RDaXx/PING37-Coupe-de-France-de-Robotique/BASE ROULANTE/MECA/Assemblage/Assemblage_moteur_roue.SLDASM

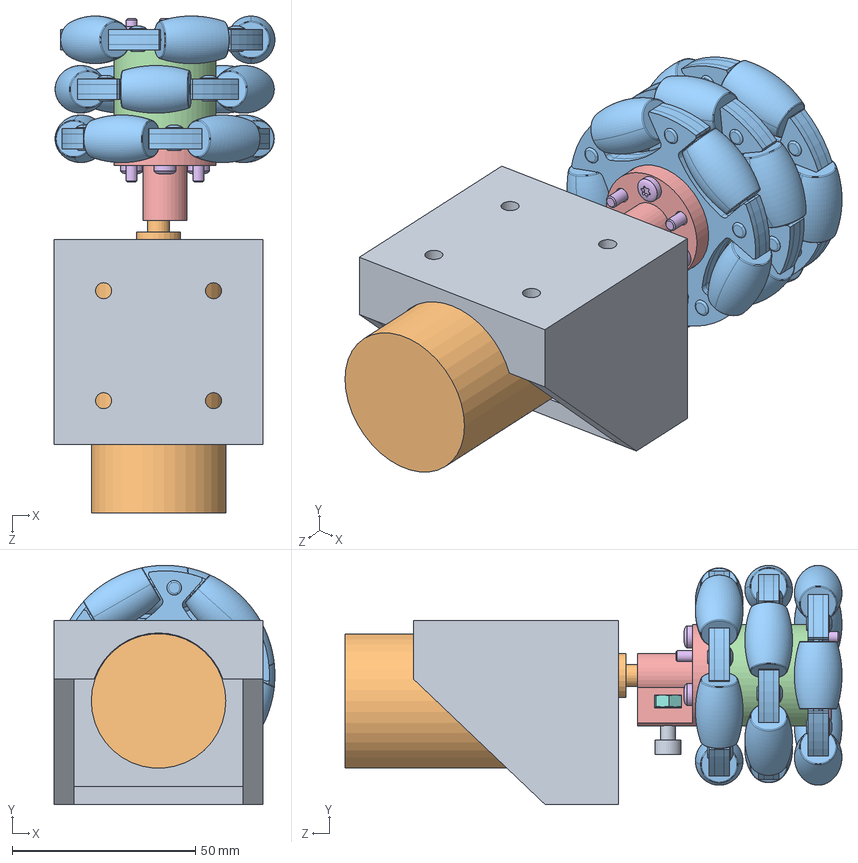
[picture p22: CAD file, 2023-02-07]
BASE ROULANTE/MECA/Assemblage/Assemblage_moteur_roue.SLDASM
60.2 x 65.3 x 135.6 mm
support_Moteur
2V DC Motor 251RPM
Omni Wheel_roller x 3
Omni Wheel_middle x 2
fixation_moteur
torx_socket_pan_head_M3x40.step x 6
Boulon_M3 x 6
Boulon_M4
M4_16
