RDaXx/PING37-Coupe-de-France-de-Robotique/BASE ROULANTE/MECA/Roue/Assemblage_roue.SLDASM

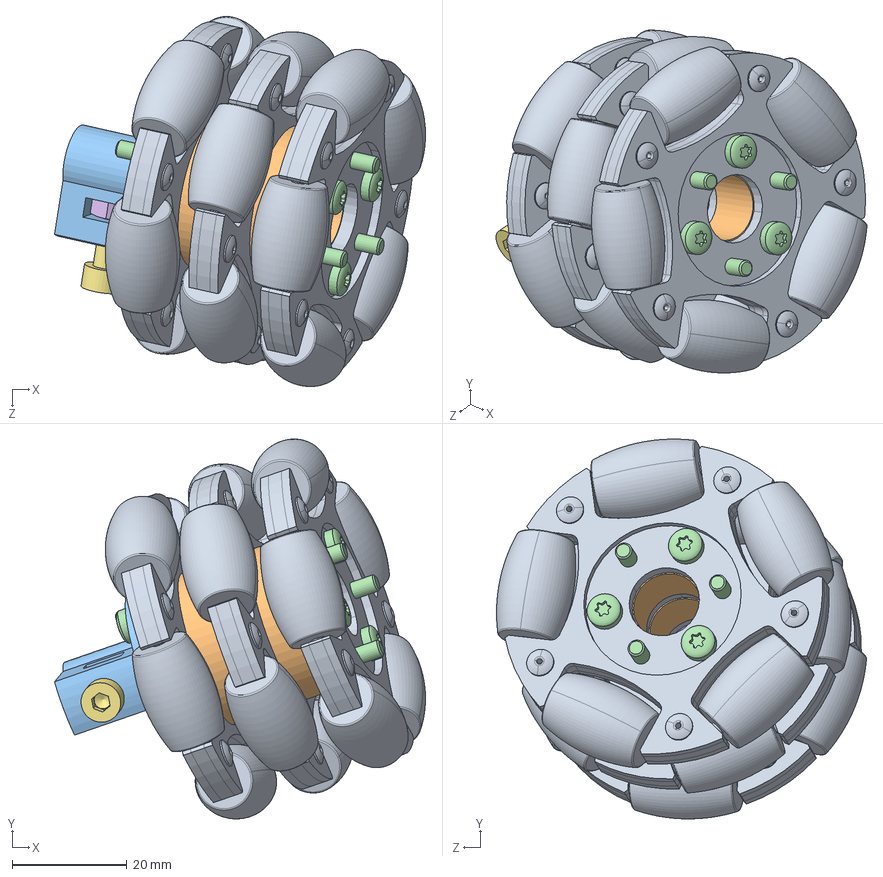
[picture p23: CAD file, 2023-02-07]
BASE ROULANTE/MECA/Roue/Assemblage_roue.SLDASM
64.6 x 66.1 x 64.4 mm
Omni Wheel_roller x 3
Omni Wheel_middle x 2
fixation_moteur
torx_socket_pan_head_M3x40.step x 6
Boulon_M3 x 6
Boulon_M4
M4_16
