RDaXx/PING37-Coupe-de-France-de-Robotique/BASE ROULANTE/MECA/Etage/etage_1.SLDPRT

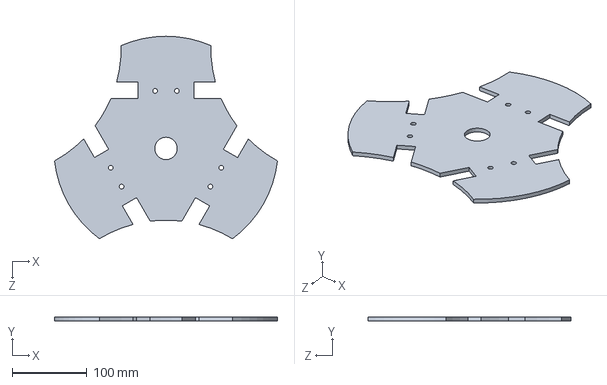
[picture p24: CAD file, 2023-02-07]
BASE ROULANTE/MECA/Etage/etage_1.SLDPRT
298.1 x 5.00 x 270.8 mm
