RDaXx/PING37-Coupe-de-France-de-Robotique/BASE ROULANTE/MECA/Moteurs/CarteMoteurs.SLDPRT

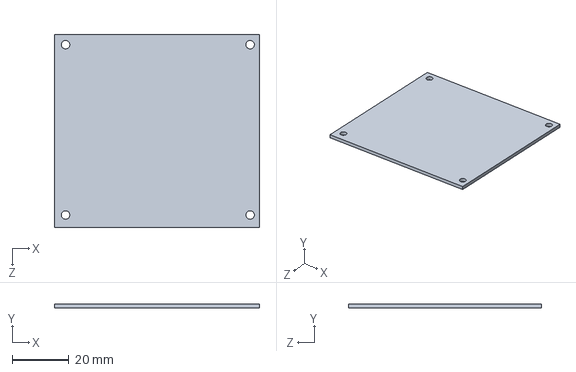
[picture p25: CAD file, 2023-02-07]
BASE ROULANTE/MECA/Moteurs/CarteMoteurs.SLDPRT
72.2 x 1.50 x 67.8 mm
