RDaXx/PING37-Coupe-de-France-de-Robotique/BASE ROULANTE/MECA/Profilé/User Library-4-AS-6-2020-VSLOT/profilé_2mm.sldprt

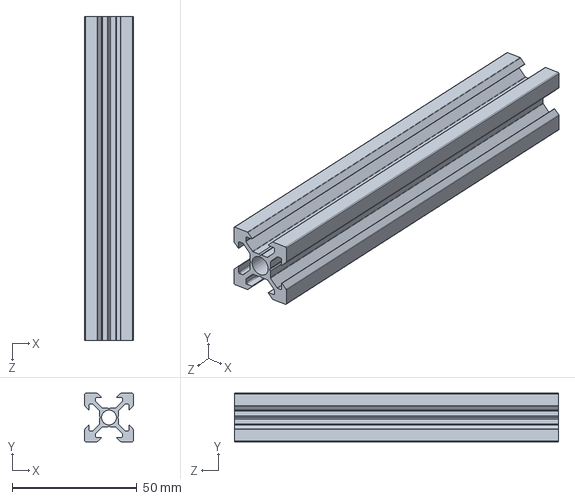
[picture p26: CAD file, 2023-02-07]
BASE ROULANTE/MECA/Profilé/User Library-4-AS-6-2020-VSLOT/profilé_2mm.sldprt
19.5 x 19.5 x 130.0 mm
