RDaXx/PING37-Coupe-de-France-de-Robotique/BASE ROULANTE/MECA/Roue/Omni Wheel_roller.SLDPRT

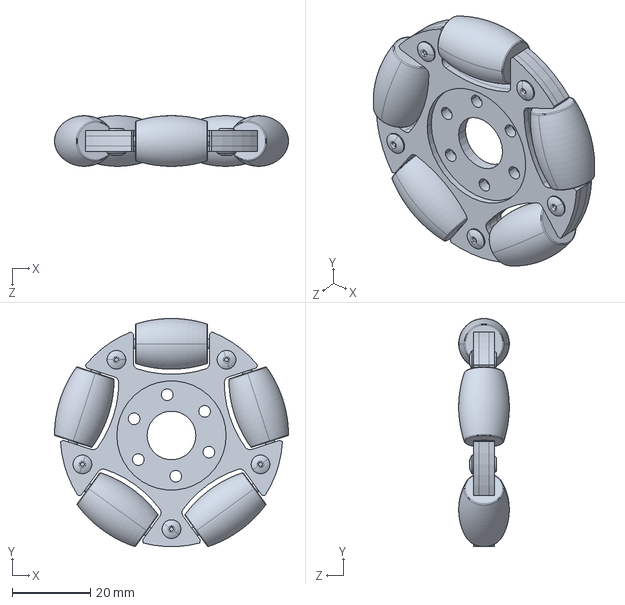
[picture p27: CAD file, 2023-02-07]
BASE ROULANTE/MECA/Roue/Omni Wheel_roller.SLDPRT
60.0 x 58.5 x 13.0 mm
