RDaXx/PING37-Coupe-de-France-de-Robotique/BASE ROULANTE/MECA/Visserie/Boulons/Boulon_M3.SLDPRT

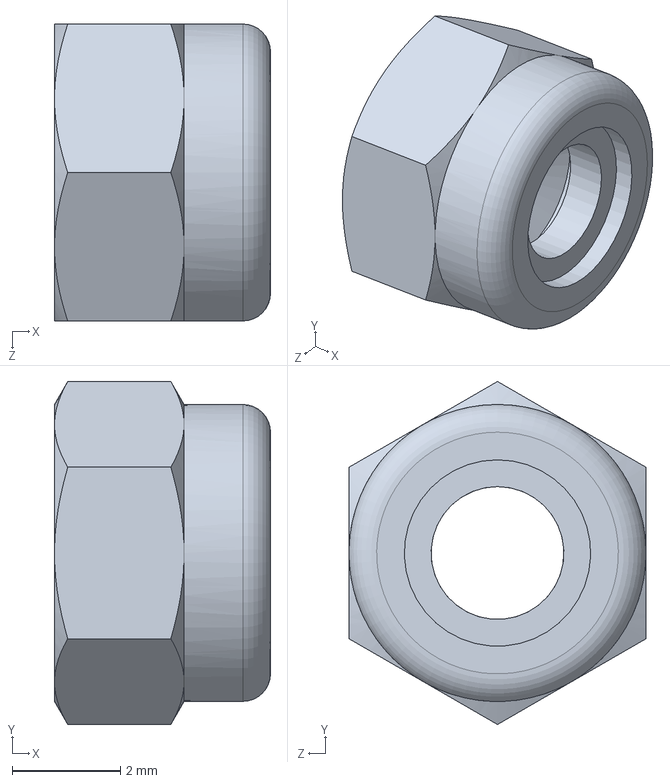
[picture p28: CAD file, 2023-02-07]
BASE ROULANTE/MECA/Visserie/Boulons/Boulon_M3.SLDPRT
4.00 x 6.35 x 5.50 mm
