RDaXx/PING37-Coupe-de-France-de-Robotique/BASE ROULANTE/MECA/Visserie/Vis/M3/torx_socket_pan_head_M3x35.step

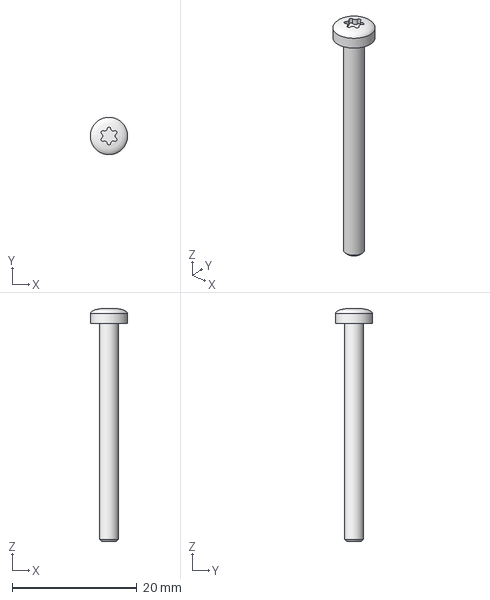
[picture p29: CAD file, 2023-02-07]
BASE ROULANTE/MECA/Visserie/Vis/M3/torx_socket_pan_head_M3x35.step
5.99 x 6.00 x 37.4 mm
