RDaXx/PING37-Coupe-de-France-de-Robotique/BASE ROULANTE/MECA/Visserie/Vis/M6/Vis_M6_20.SLDPRT

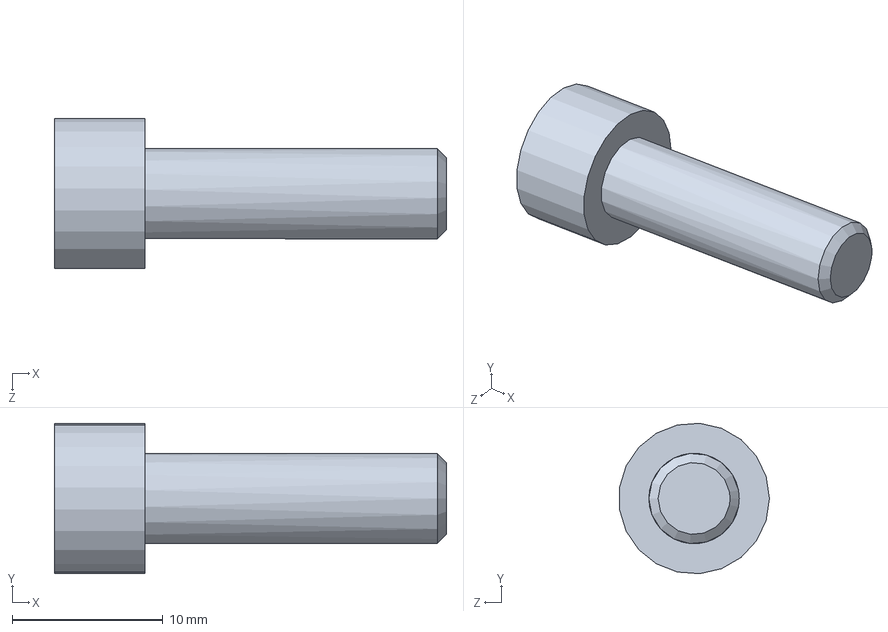
[picture p30: CAD file, 2023-02-07]
BASE ROULANTE/MECA/Visserie/Vis/M6/Vis_M6_20.SLDPRT
26.0 x 9.97 x 9.94 mm
