RDaXx/PING37-Coupe-de-France-de-Robotique/BASE ROULANTE/MECA/Etage/etage_2.SLDPRT

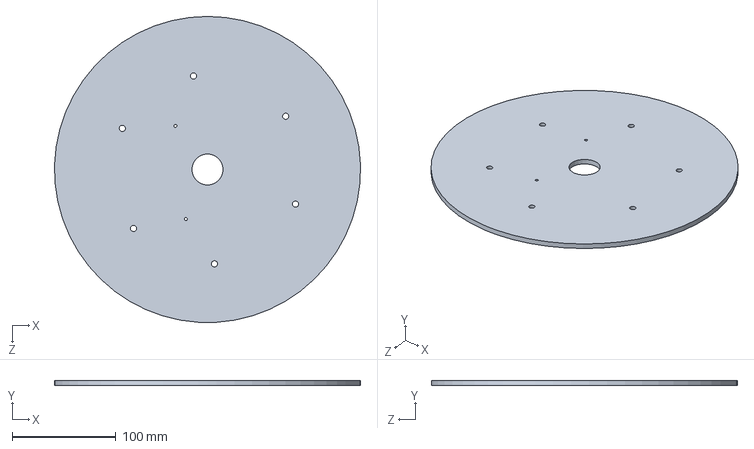
[picture p31: CAD file, 2023-02-07]
BASE ROULANTE/MECA/Etage/etage_2.SLDPRT
294.9 x 5.00 x 295.0 mm
