RDaXx/PING37-Coupe-de-France-de-Robotique/BASE ROULANTE/MECA/Moteurs/Support_CarteMoteursV2.SLDPRT

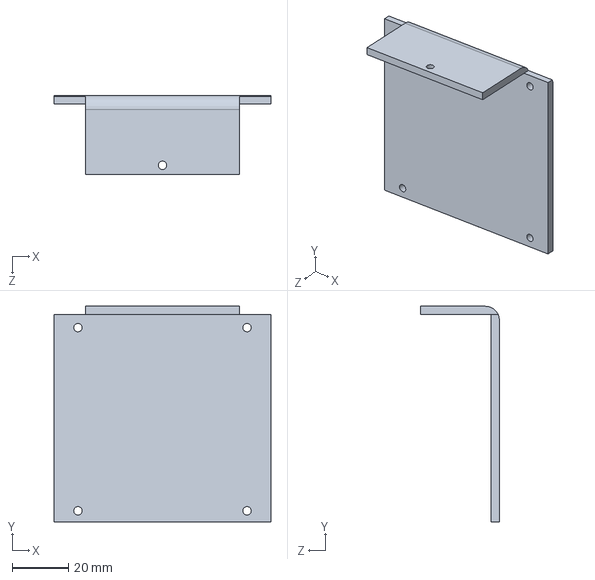
[picture p32: CAD file, 2023-02-07]
BASE ROULANTE/MECA/Moteurs/Support_CarteMoteursV2.SLDPRT
77.0 x 76.5 x 28.0 mm
