RDaXx/PING37-Coupe-de-France-de-Robotique/BASE ROULANTE/MECA/Roue/fixation_moteur.SLDPRT

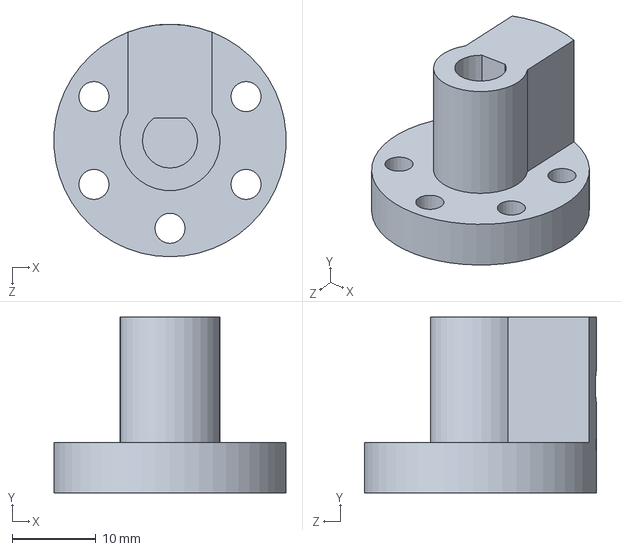
[picture p33: CAD file, 2023-02-07]
BASE ROULANTE/MECA/Roue/fixation_moteur.SLDPRT
27.7 x 21.0 x 27.8 mm
