RDaXx/PING37-Coupe-de-France-de-Robotique/BASE ROULANTE/MECA/Visserie/Boulons/Boulon_M4.SLDPRT

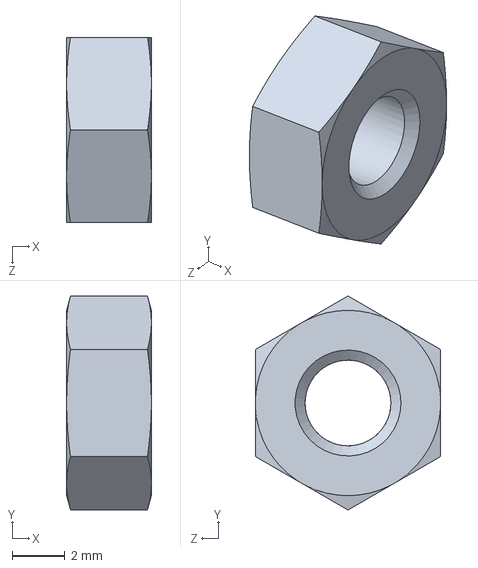
[picture p34: CAD file, 2023-02-07]
BASE ROULANTE/MECA/Visserie/Boulons/Boulon_M4.SLDPRT
3.20 x 8.08 x 7.00 mm
