RDaXx/PING37-Coupe-de-France-de-Robotique/BASE ROULANTE/MECA/Visserie/Vis/M3/torx_socket_pan_head_M3x25.step

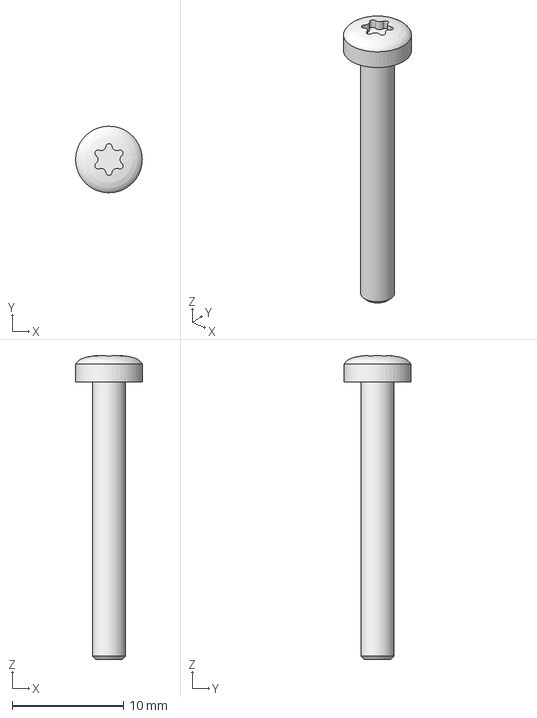
[picture p35: CAD file, 2023-02-07]
BASE ROULANTE/MECA/Visserie/Vis/M3/torx_socket_pan_head_M3x25.step
5.99 x 6.00 x 27.4 mm
