RDaXx/PING37-Coupe-de-France-de-Robotique/BASE ROULANTE/MECA/Visserie/Vis/M6/Vis_M6_30.SLDPRT

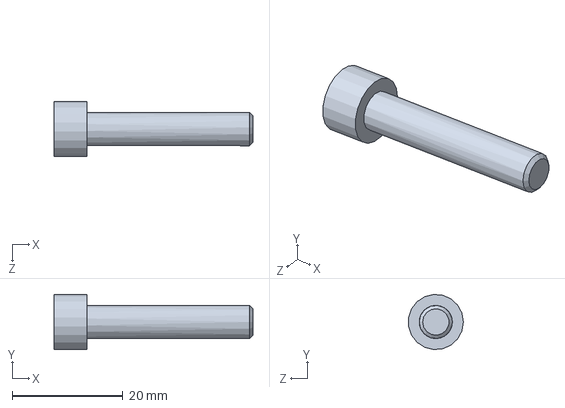
[picture p36: CAD file, 2023-02-07]
BASE ROULANTE/MECA/Visserie/Vis/M6/Vis_M6_30.SLDPRT
36.0 x 9.97 x 9.93 mm
