RDaXx/PING37-Coupe-de-France-de-Robotique/BASE ROULANTE/MECA/Etage/baseRoulanteV3.SLDPRT

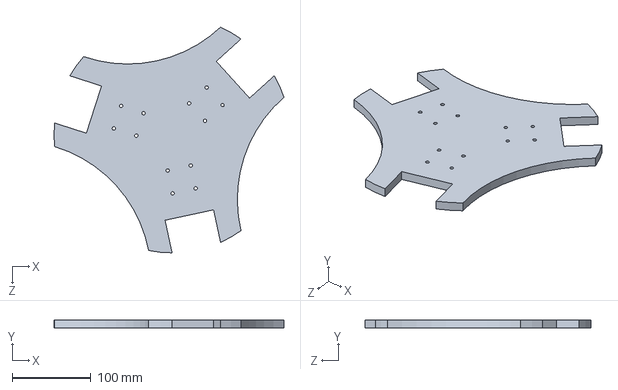
[picture p37: CAD file, 2023-02-07]
BASE ROULANTE/MECA/Etage/baseRoulanteV3.SLDPRT
292.2 x 10.0 x 286.8 mm
