RDaXx/PING37-Coupe-de-France-de-Robotique/BASE ROULANTE/MECA/Moteurs/support_Moteur.SLDPRT

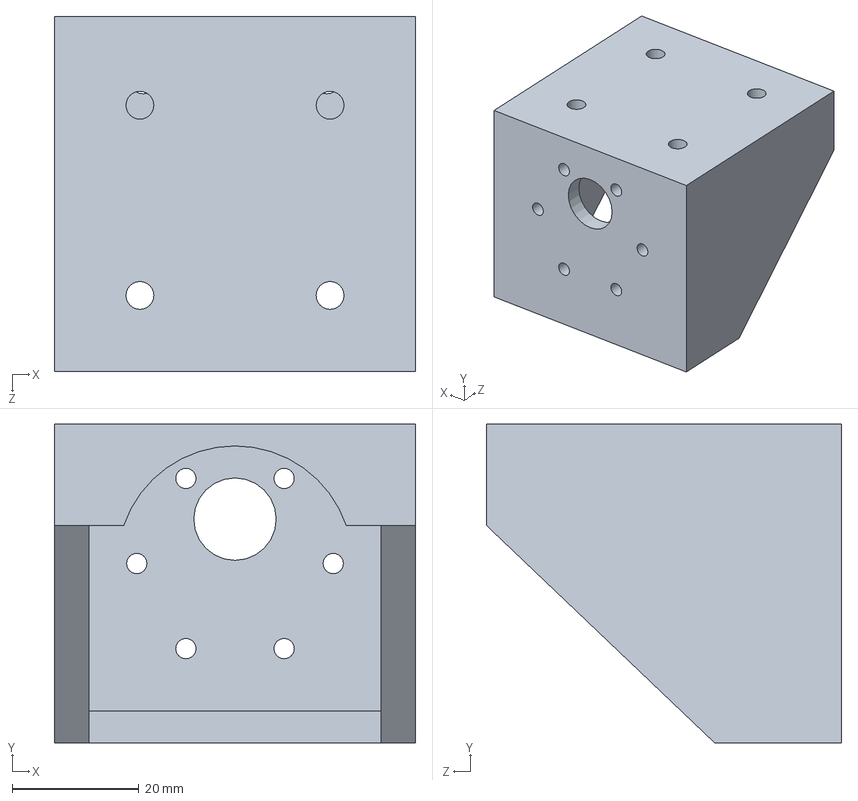
[picture p38: CAD file, 2023-02-07]
BASE ROULANTE/MECA/Moteurs/support_Moteur.SLDPRT
57.0 x 50.3 x 56.0 mm
