RDaXx/PING37-Coupe-de-France-de-Robotique/BASE ROULANTE/MECA/Visserie/Boulons/Boulon_M6.SLDPRT

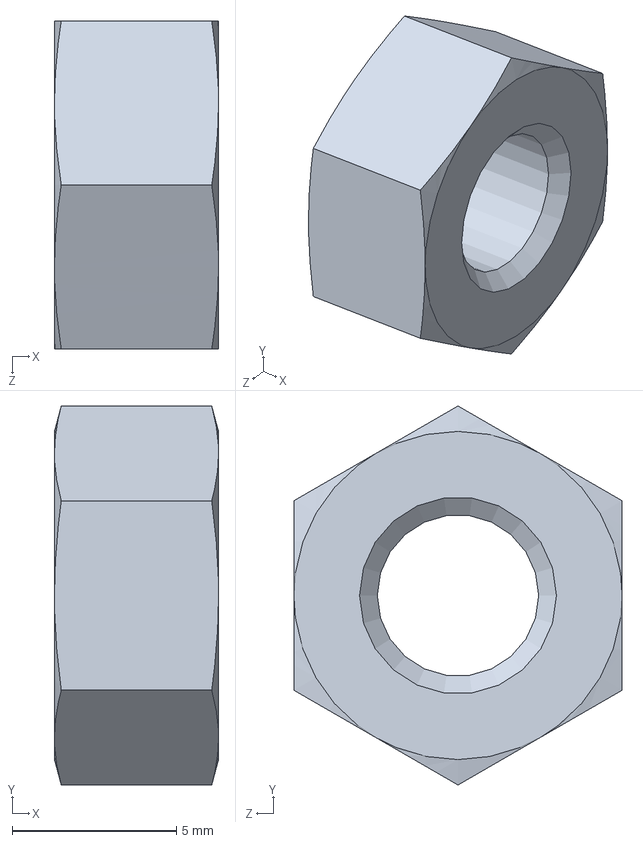
[picture p39: CAD file, 2023-02-07]
BASE ROULANTE/MECA/Visserie/Boulons/Boulon_M6.SLDPRT
5.00 x 11.5 x 10.0 mm
