RDaXx/PING37-Coupe-de-France-de-Robotique/BASE ROULANTE/MECA/Moteurs/2V DC Motor 251RPM.SLDPRT

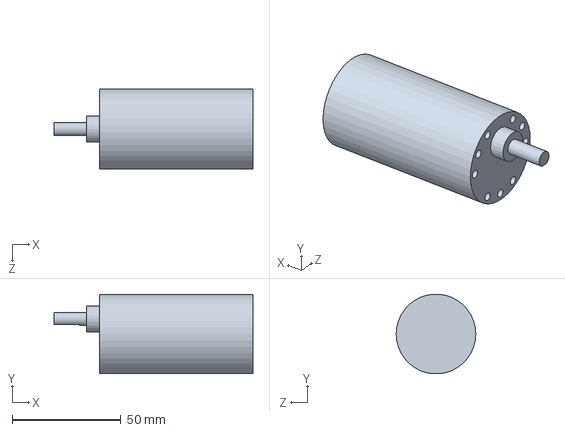
[picture p40: CAD file, 2023-02-07]
BASE ROULANTE/MECA/Moteurs/2V DC Motor 251RPM.SLDPRT
91.6 x 36.6 x 36.7 mm
