RDaXx/PING37-Coupe-de-France-de-Robotique/BASE ROULANTE/MECA/Roue/Omni Wheel_middle.SLDPRT

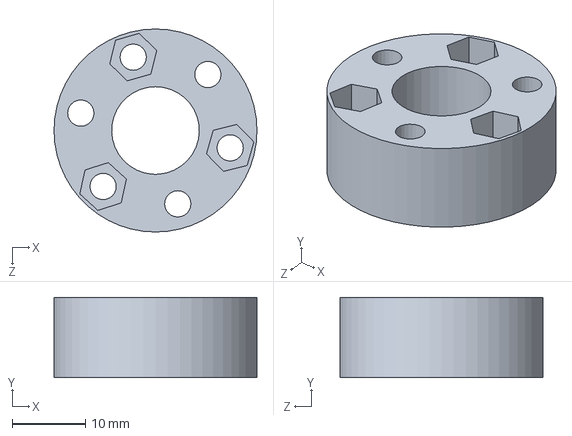
[picture p41: CAD file, 2023-02-07]
BASE ROULANTE/MECA/Roue/Omni Wheel_middle.SLDPRT
27.8 x 11.0 x 27.8 mm
