RDaXx/PING37-Coupe-de-France-de-Robotique/(list of files, cad)

Other CAD files:
BASE ROULANTE/MECA/Visserie/Vis/M3/M3x30.SLDPRT
BASE ROULANTE/MECA/Visserie/Vis/M4/M4_10.SLDPRT
BASE ROULANTE/MECA/Visserie/Vis/M4/M4_16.SLDPRT
