RDaXx/PING37-Coupe-de-France-de-Robotique/BASE ROULANTE/ELEC/Carte moteurs/carte_Moteurs.brd

## EAGLE design BASE ROULANTE/ELEC/Carte moteurs/carte_Moteurs.brd (2023-02-07)

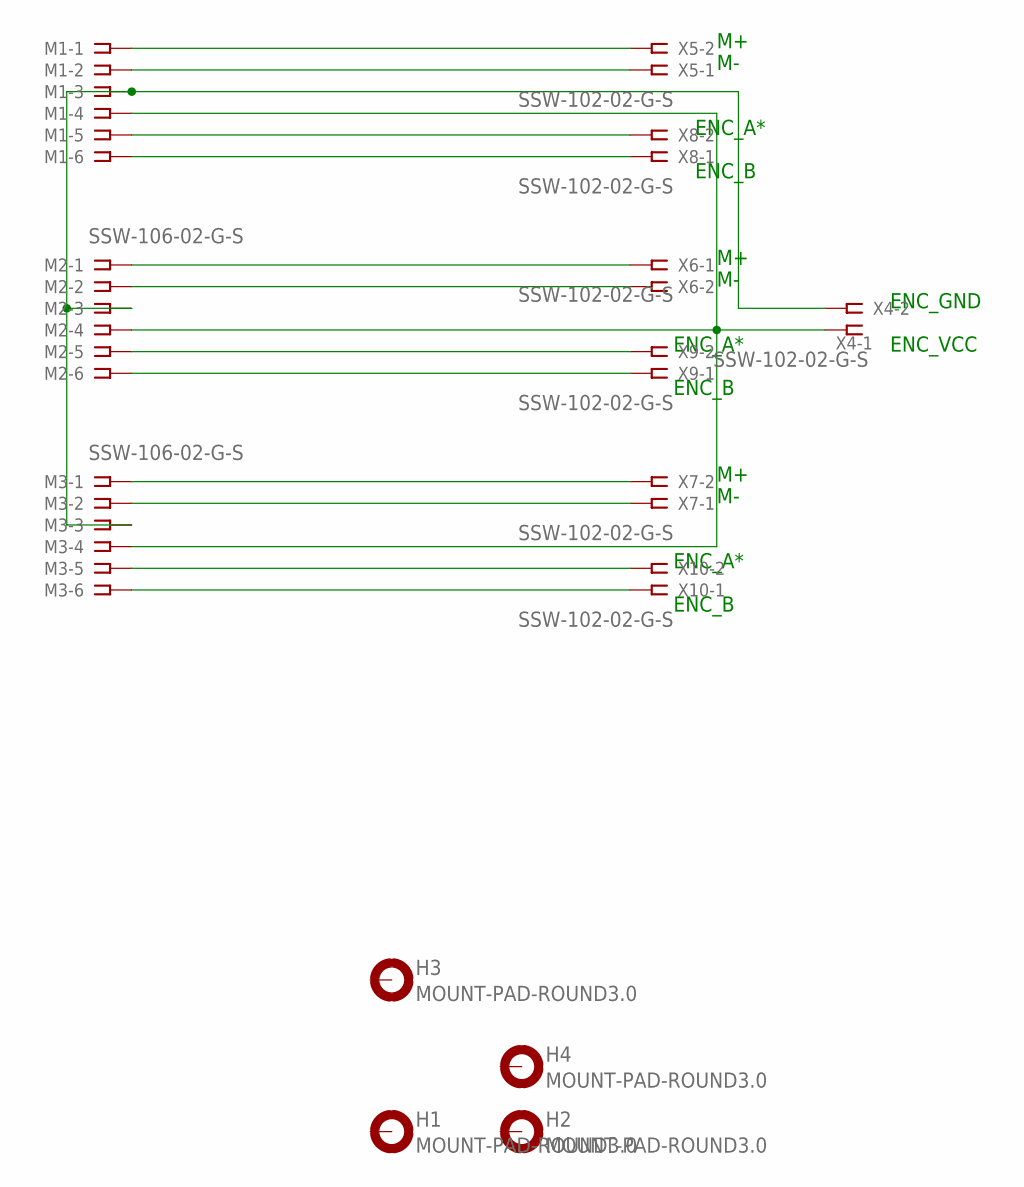
[picture p54: schematic carte_Moteurs.sch]

Parts:
H1, H2, H3, H4: MOUNT-PAD-ROUND3.0; 3,0-PAD
M1: SSW-106-02-G-S; MPN Motor1
M2, M3: SSW-106-02-G-S
X4, X5, X6, X7, X8, X9, X10: SSW-102-02-G-S

Connections:
unnamed: M1.1, X5.2
unnamed: M1.2, X5.1
unnamed: M2.1, X6.1
unnamed: M2.2, X6.2
unnamed: M3.1, X7.2
unnamed: M3.2, X7.1
unnamed: M1.6, X8.1
unnamed: M1.5, X8.2
unnamed: M2.5, X9.2
unnamed: M2.6, X9.1
unnamed: M3.5, X10.2
unnamed: M3.6, X10.1
unnamed: M1.3, M2.3, M3.3, X4.2
unnamed: M1.4, M2.4, M3.4, X4.1

Notes on the sheet:
ENC_GND
ENC_VCC
ENC_A*
ENC_B

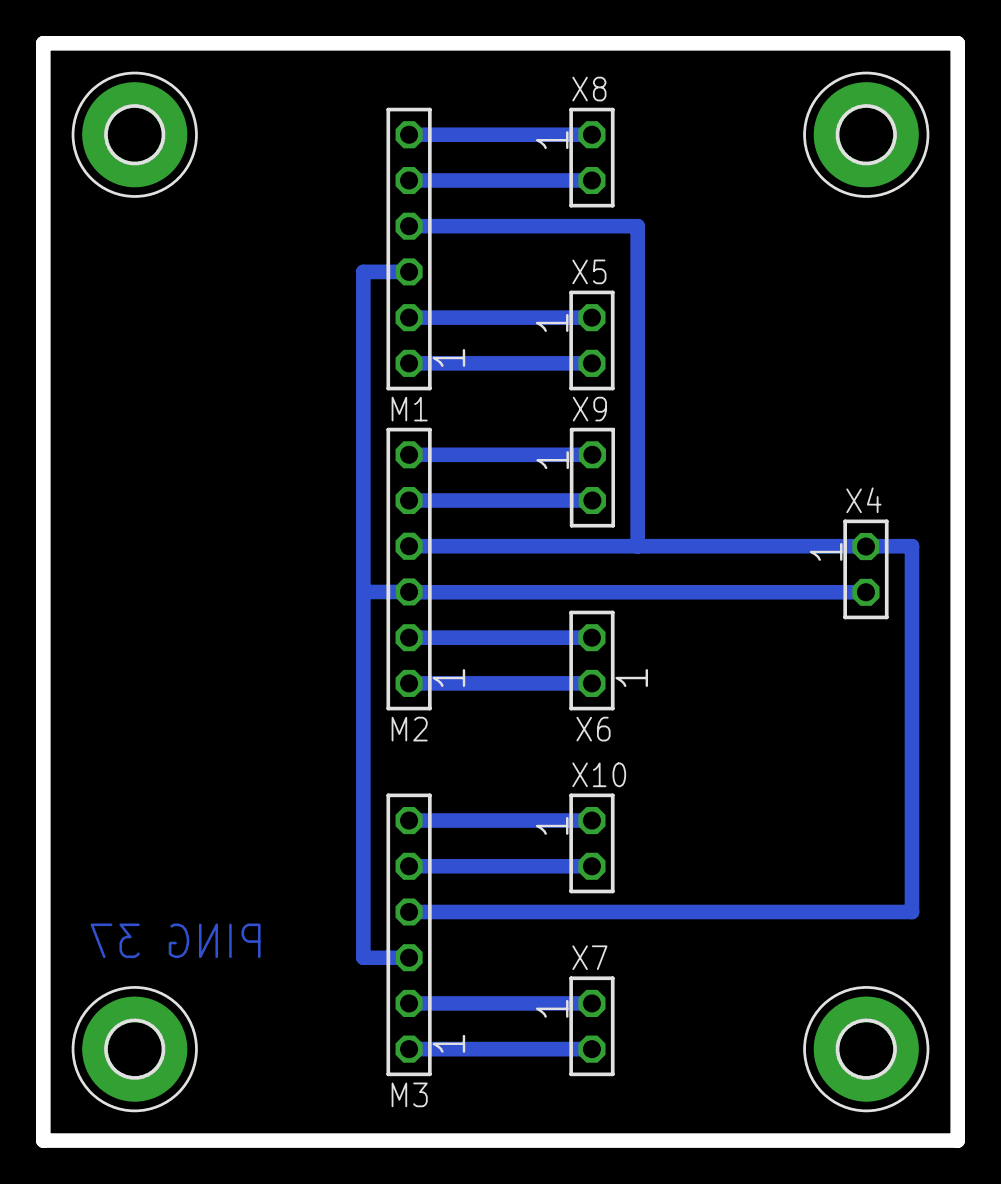
[picture p55: board carte_Moteurs.brd from above]

Board: 2 copper layers, 50.8 x 61.0 mm, 14 parts (0 on the bottom side), 14 nets.
