RDaXx/PING37-Coupe-de-France-de-Robotique/BASE ROULANTE/ELEC/Carte de puissance/schéma_Carte_Puissance.brd

## EAGLE design BASE ROULANTE/ELEC/Carte de puissance/schéma_Carte_Puissance.brd (2023-02-07)

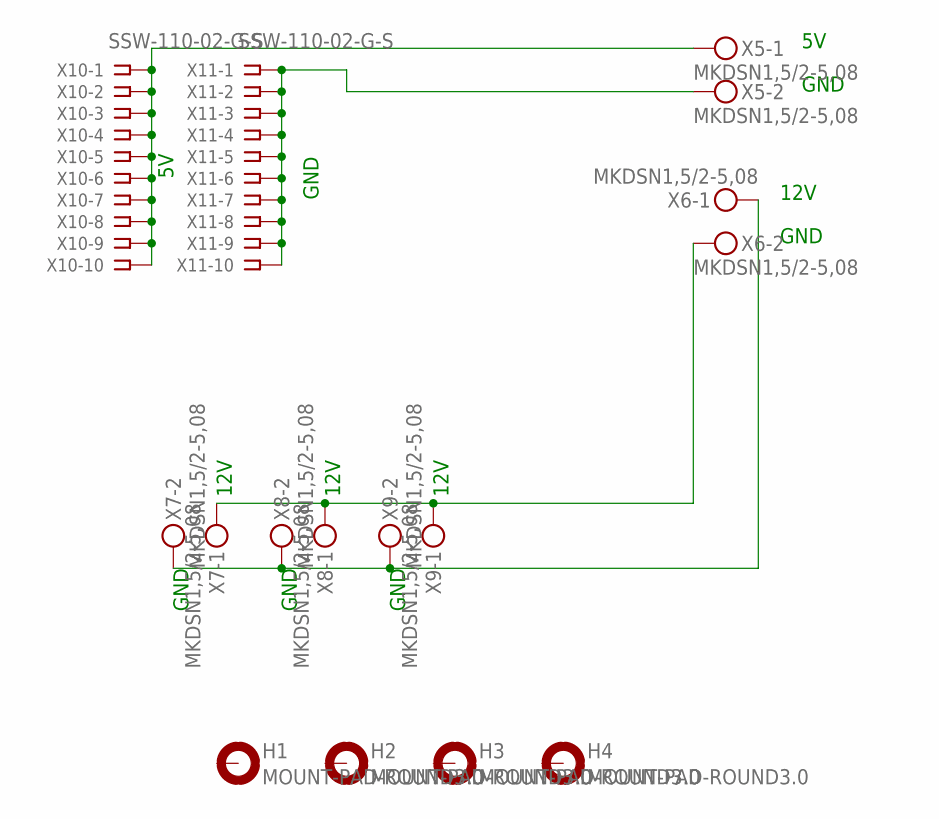
[picture p56: schematic schéma_Carte_Puissance.sch]

Parts:
H1, H2, H3, H4: MOUNT-PAD-ROUND3.0; 3,0-PAD
X5, X6, X7, X8, X9: MKDSN1,5/2-5,08
X10, X11: SSW-110-02-G-S

Connections:
unnamed: X5.1, X10.1, X10.2, X10.3, X10.4, X10.5, X10.6, X10.7, X10.8, X10.9, X10.10
unnamed: X5.2, X11.1, X11.2, X11.3, X11.4, X11.5, X11.6, X11.7, X11.8, X11.9, X11.10
unnamed: X6.2, X7.1, X8.1, X9.1
unnamed: X6.1, X7.2, X8.2, X9.2

Notes on the sheet:
GND
12V

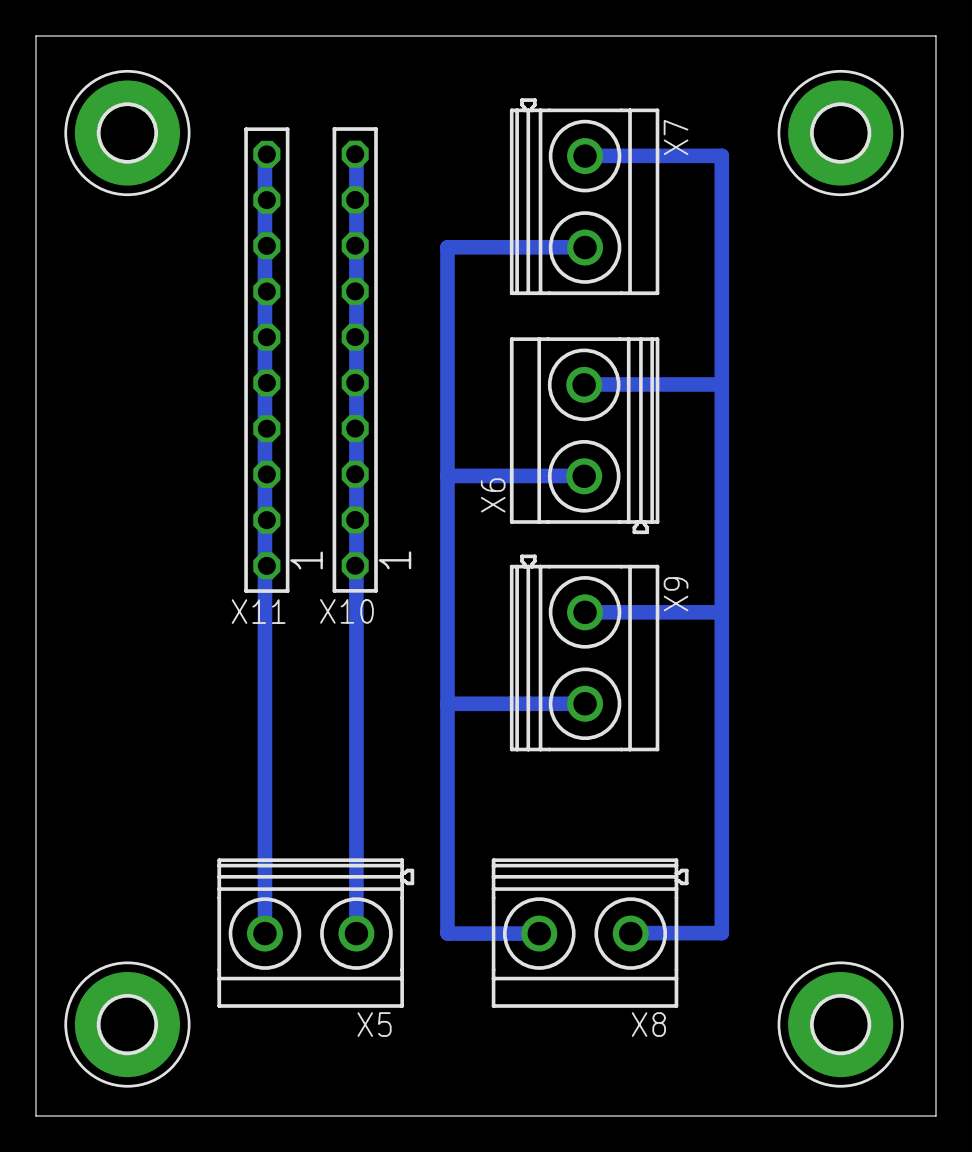
[picture p57: board schéma_Carte_Puissance.brd from above]

Board: 2 copper layers, 50.0 x 60.0 mm, 11 parts (0 on the bottom side), 4 nets.
