RDaXx/PING37-Coupe-de-France-de-Robotique/BASE ROULANTE/BaseRoulante/RobotPin.h

#ifndef _ROBOTPIN_h
#define _ROBOTPIN_h

/********PIN*********/
//Motor 1
#define ENCODER_M1_A 2
#define ENCODER_M1_B 28
#define PWM_M1 5
#define DIR_M1 22

//Motor 2
#define ENCODER_M2_A 3
#define ENCODER_M2_B 30
#define PWM_M2 6
#define DIR_M2 24

//Motor 3
#define ENCODER_M3_A 18
#define ENCODER_M3_B 32
#define PWM_M3 7
#define DIR_M3 26

#endif
